imt-emabot/CFR_2027/commun/outils/ImgToGcode/image.png

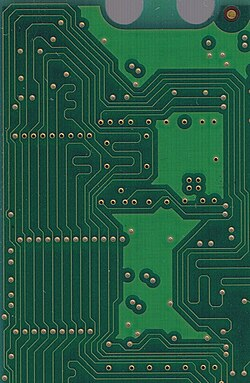
commun/outils/ImgToGcode/image.png
