imt-emabot/CFR_2027/mat/elec/README.md

# Électronique — mât

Rien de dédié pour l'instant. Le calculateur est un Raspberry Pi 5 du commerce (CDC mât,
section 7) et la batterie proposée est une batterie d'outillage électroportatif avec
convertisseur du commerce, sans PCB dédié (section 8.1). Ce dossier reçoit ce qui
deviendrait nécessaire — point d'accès dédié (section 6.2), câblage d'alimentation.
