imt-emabot/CFR_2027/pami/meca/README.md

# Mécanique — PAMI

Mécanique des sept PAMI. Contrainte de gabarit réglementaire : 150 mm au départ, 350 mm
déployés (CDC logiciel, section 14.6).
