imt-emabot/CFR_2027/robot_principal/elec/alim/README.md

# Carte alimentation

STM32. Entrée LiPo 4S. Sorties 5 V puissance, 5 V commande, 5 V Pi, 12 V puissance.
Mesure de courant et tension par INA3221 (3 canaux, 0,25 %) sur shunts de 8 mΩ 1 W.
Sorties commutées par relais G2RL-2 DPDT 8 A 12 V. DAC MCP4725 présent.

Renvois : CDC logiciel, section 1.3 (chiffrage de la résolution et de la limite de
courant réelle), section 11.2 (contraintes de coupure).
