imt-emabot/CFR_2027/robot_principal/elec/carte_bat/README.md

# Carte batterie

STM32. Carte de gestion de la batterie du robot principal, distincte de la carte
alimentation (`../alim/`) qui distribue le courant vers les sorties.
