imt-emabot/CFR_2027/robot_principal/logiciel/core/README.md

# core

Processus qui ne doit jamais tomber en match (CDC logiciel, section 4.4) : tirette,
machine à états de match, passerelle CAN, chien de garde, pilote lidar et réflexe
obstacle, IHM d'état.

Renvois : contrat de la carte moteurs (section 7), bus CAN (section 8), lidar remonté en
couche 1 (section 9.1).
