imt-emabot/CFR_2027/robot_principal/logiciel/perception/README.md

# perception

Caméra embarquée et client du mât (CDC logiciel, section 4.4). Peut redémarrer en match.

Renvois : caméra embarquée (section 9.2), dispositif de calcul et d'observation déporté
et calibration continue (section 10). Le mât n'est jamais un participant DDS : ce paquet
est la passerelle applicative qui reçoit ses messages UDP (CDC mât, section 6.4).
