imt-emabot/CFR_2027/robot_principal/logiciel/tooling/README.md

# tooling

Enregistrement, télémétrie, visualisation (CDC logiciel, section 4.4). Tué d'office au
coup de tirette en mode match officiel — F.6 interdit toute communication avec un système
extérieur à la table pendant un match (section 12).

Renvois : enregistrement, rejeu et capitalisation (section 5.7 et section 19). Le pont
vers le simulateur est un composant séparé, voir `../simulateur/`.
