imt-emabot/CFR_2027/docs/README.md

# Documentation

Documents transverses au projet.

- `cdc/` — cahiers des charges et leur outillage de traçabilité. Voir
  [`cdc/conventions-cdc.md`](cdc/conventions-cdc.md) avant toute modification.
- `robotcoup.drawio` / `robotcoup.drawio.png` — schéma du robot.
- [`procedure-preparation-3min.md`](procedure-preparation-3min.md) — procédure de
  préparation en trois minutes (fiche 17.11 du CDC logiciel).
- [`analyse-reglement-2027-beta.md`](analyse-reglement-2027-beta.md) — confrontation du
  règlement 2027 bêta aux CDC ; liste de travail avant la passe de révision.
