imt-emabot/CFR_2027/commun/README.md

# Commun

Ce qui ne relève d'aucun sous-système en particulier — robot principal, mât ou PAMI —
mais s'applique à plusieurs d'entre eux.

- [`elec/`](elec/) — normes électriques internes à l'équipe.
- [`outils/`](outils/) — utilitaires de fabrication.
