imt-emabot/CFR_2027/mat/README.md

# Mât — dispositif de calcul et d'observation déporté

Tout ce qui constitue le mât : électronique, mécanique, logiciel.

- [`elec/`](elec/) — électronique du mât.
- [`meca/`](meca/) — structure mécanique du mât.
- [`logiciel/`](logiciel/) — logiciel du calculateur embarqué.

L'architecture, les choix actés et leurs motifs vivent dans `docs/cdc/cdc-mat-v0_3.md` ;
ces dossiers n'en sont que la structure de code (règle 5 de `docs/cdc/conventions-cdc.md`).
