imt-emabot/CFR_2027/pami/elec/README.md

# Électronique — PAMI

Électronique embarquée des sept PAMI : microcontrôleur Wi-Fi, démarreur physique propre
à chaque PAMI, sélecteur de couleur d'équipe et sélecteur de numéro — les trois servent au
niveau de repli 3, quand le PAMI n'a jamais été connecté au serveur (CDC logiciel, section
14.3).
