imt-emabot/CFR_2027/commun/elec/README.md

# Électronique — commun

- `norme_intern_elec.xlsx` — normes électriques internes à l'équipe, applicables à toutes
  les cartes, quel que soit le sous-système.
