imt-emabot/CFR_2027/commun/outils/README.md

# Outils — commun

Scripts et utilitaires de fabrication, indépendants de tout sous-système.

- `ImgToGcode/` — conversion d'une image en G-code (détection de contours OpenCV) pour
  découpe/gravure.
