imt-emabot/CFR_2027/mat/meca/README.md

# Mécanique — mât

Structure du mât, deux options maintenues en parallèle à ce stade (CDC mât, section 8.3).
Ventilateur actif obligatoire pour le calculateur en boîtier fermé (section 7).
