imt-emabot/CFR_2027/robot_principal/meca/README.md

# Mécanique — robot principal

Pièces et sous-ensembles mécaniques du robot principal (conceptions Fusion 360).

- `support ventilo.f3d` — support de refroidissement de l'électronique embarquée.
