imt-emabot/CFR_2027/robot_principal/logiciel/nav/README.md

# nav

Nav2, costmaps, planificateur global (CDC logiciel, section 4.4). Peut redémarrer en
match, `RestartSec` croissant.

Renvois : navigation et articulation avec la carte moteurs par flux de waypoints
remplaçable (sections 4.2 et 5), dimensionnement de l'évitement (section 5.4).
