imt-emabot/CFR_2027/robot_principal/logiciel/strategy/README.md

# strategy

Moteur de stratégie (CDC logiciel, section 4.4). Peut redémarrer en match ; le robot
bascule sur une séquence forcée pendant son absence.

Renvois : stratégie et machine à états de match (section 11), fenêtre PAMI et niveaux de
repli à sélectionner (section 14.6), format du fichier de description des actions
(section 17.6, à figer).
