imt-emabot/CFR_2027/docs/cdc/matrice-tracabilite.md

# Matrice de traçabilité

*Généré par `verif_cdc.py --matrice`. Ne pas modifier à la main.*

## LOG — Logiciel embarqué du robot principal

| Exigence | Origine | Vérif. | Essais | Liens sortants | Liens entrants |
|---|---|---|---|---|---|
| LOG-EXD-01 | B2 | E | — | — | — |
| LOG-EXD-02 | B4 | I | — | — | — |
| LOG-EXD-03 | B6 | I | — | — | — |
| LOG-EXD-04 | B2 | I | — | — | — |
| LOG-EXD-05 | B1, B6 | I | — | — | — |
| LOG-EXE-01 | — | E | V6 | — | MAT-MXE-01, MAT-MXF-11 |
| LOG-EXE-02 | — | I | — | — | — |
| LOG-EXE-03 | — | E | — | — | — |
| LOG-EXE-04 | — | I | — | — | — |
| LOG-EXE-05 | — | EI | — | — | — |
| LOG-EXE-06 | — | E | V4 | — | — |
| LOG-EXE-07 | — | I | — | — | — |
| LOG-EXF-01 | B3 | E | — | — | — |
| LOG-EXF-02 | B3 | E | — | — | — |
| LOG-EXF-03 | B3 | E | — | — | — |
| LOG-EXF-04 | B3 | E | — | — | — |
| LOG-EXF-05 | B3 | E | — | — | — |
| LOG-EXF-06 | B1 | I | — | — | — |
| LOG-EXF-07 | B2, B5 | E | — | — | — |
| LOG-EXF-08 | B3 | E | — | — | MAT-MXF-03 |
| LOG-EXF-09 | B2 | E | V2 | — | MAT-MXS-03 |
| LOG-EXF-10 | B3 | E | — | — | — |
| LOG-EXF-11 | B3 | AE | V13 | — | MAT-MXF-04, MAT-MXF-05, MAT-MXP-06 |
| LOG-EXF-12 | B3, B4 | E | V8 | — | — |
| LOG-EXF-13 | B4 | I | — | — | — |
| LOG-EXJ-01 | — | E | V9 | — | — |
| LOG-EXJ-02 | — | E | V9 | — | — |
| LOG-EXJ-03 | — | E | V9 | — | — |
| LOG-EXJ-04 | — | AE | V9 | — | MAT-MXF-12, MAT-MXP-03 |
| LOG-EXJ-05 | — | I | V9 | — | — |
| LOG-EXJ-06 | — | I | V9 | — | — |
| LOG-EXJ-07 | — | AE | V9 | — | — |
| LOG-EXJ-08 | — | E | V9 | — | — |
| LOG-EXJ-09 | — | E | V9 | — | — |
| LOG-EXJ-10 | — | I | V9 | — | — |
| LOG-EXJ-11 | — | E | V9 | — | — |
| LOG-EXJ-12 | — | E | V10 | — | — |
| LOG-EXJ-13 | — | EI | V10 | — | — |
| LOG-EXJ-14 | — | E | V10 | — | — |
| LOG-EXJ-15 | — | I | V10 | — | — |
| LOG-EXP-01 | — | AE | V8 | — | — |
| LOG-EXP-02 | — | E | — | — | — |
| LOG-EXP-03 | — | AE | V8 | — | — |
| LOG-EXP-04 | — | A | — | — | — |
| LOG-EXP-05 | — | E | — | — | — |
| LOG-EXP-07 | — | E | V11 | — | — |
| LOG-EXR-01 | H.3, H.4 | EH | V5 | — | — |
| LOG-EXR-02 | H.4 | E | V5 | — | — |
| LOG-EXR-03 | H.4, I.3.b | EH | V1 | — | — |
| LOG-EXR-04 | H.4 | I | — | — | — |
| LOG-EXR-05 | H.1, H.4 | E | V6 | — | — |
| LOG-EXR-06 | H.4 | E | V6 | — | — |
| LOG-EXR-07 | H.4 | AE | — | — | — |
| LOG-EXR-08 | F.6 | I | — | — | MAT-MXR-06 |
| LOG-EXR-09 | I.3.b | H | V7 | — | — |
| LOG-EXR-10 | F.3 | EI | V7 | — | — |
| LOG-EXR-11 | F.6 | I | — | — | MAT-MXR-08 |
| LOG-EXR-12 | F.6 | I | — | — | — |
| LOG-EXS-01 | P6 | E | V4 | — | — |
| LOG-EXS-02 | P3 | E | V1 | — | — |
| LOG-EXS-03 | P3 | E | V2 | — | MAT-MXS-02 |
| LOG-EXS-04 | P4 | E | V5 | — | — |
| LOG-EXS-05 | P3, P4 | E | V1 | — | — |
| LOG-EXS-06 | P4 | E | V11 | — | — |
| LOG-EXS-07 | P4 | EI | V12 | — | MAT-MXS-05 |
| LOG-EXS-08 | P4 | I | V12 | — | — |
| LOG-EXS-09 | B2 | E | V3 | — | — |
| LOG-EXS-10 | B2 | E | V3 | — | — |
| LOG-EXS-11 | B4 | E | V12 | — | — |
| LOG-EXS-12 | P2 | AE | V13 | — | MAT-MXP-01, MAT-MXS-04 |

## MAT — Dispositif de calcul et d'observation déporté

| Exigence | Origine | Vérif. | Essais | Liens sortants | Liens entrants |
|---|---|---|---|---|---|
| MAT-MXD-01 | Q1, B6 | I | — | — | — |
| MAT-MXD-02 | Q1 | E | M3 | — | — |
| MAT-MXD-03 | B6 | I | — | — | — |
| MAT-MXD-04 | B6 | I | — | — | — |
| MAT-MXE-01 | — | E | M1 | LOG-EXE-01 | — |
| MAT-MXE-02 | — | E | M1 | — | — |
| MAT-MXE-03 | — | I | — | — | — |
| MAT-MXE-04 | — | I | — | — | — |
| MAT-MXE-05 | — | I | — | — | — |
| MAT-MXE-06 | — | E | M8 | — | — |
| MAT-MXF-01 | B1 | E | — | — | — |
| MAT-MXF-02 | B2 | E | — | — | — |
| MAT-MXF-03 | B2 | E | — | LOG-EXF-08 | — |
| MAT-MXF-04 | B3 | E | — | LOG-EXF-11 | — |
| MAT-MXF-05 | B3 | EI | M6b | LOG-EXF-11 | — |
| MAT-MXF-06 | B3 | E | M8 | — | — |
| MAT-MXF-07 | B5 | E | — | — | — |
| MAT-MXF-08 | B3 | AE | — | — | — |
| MAT-MXF-09 | B4 | E | M3 | — | — |
| MAT-MXF-10 | B2 | I | — | — | — |
| MAT-MXF-11 | B5 | I | M8 | LOG-EXE-01 | — |
| MAT-MXF-12 | B3 | AE | M6b | LOG-EXJ-04 | — |
| MAT-MXP-01 | — | AE | M6 | LOG-EXS-12 | — |
| MAT-MXP-02 | — | AE | M6 | — | — |
| MAT-MXP-03 | — | AE | M6 | LOG-EXJ-04 | — |
| MAT-MXP-04 | — | AE | M5 | — | — |
| MAT-MXP-05 | — | E | M4 | — | — |
| MAT-MXP-06 | — | AE | M6b | LOG-EXF-11 | — |
| MAT-MXR-01 | G.4 | HI | M9 | — | — |
| MAT-MXR-02 | G.4 | HI | M9 | — | — |
| MAT-MXR-03 | G.4 | HI | M9 | — | — |
| MAT-MXR-04 | G.4 | HI | M1 | — | — |
| MAT-MXR-05 | F.4.c | I | M10 | — | — |
| MAT-MXR-06 | F.6 | I | M10 | LOG-EXR-08 | — |
| MAT-MXR-07 | F.4.b | HI | M10 | — | — |
| MAT-MXR-08 | F.6 | HI | M10 | LOG-EXR-11 | — |
| MAT-MXS-01 | Q1 | E | M3 | — | — |
| MAT-MXS-02 | Q2 | E | M2 | LOG-EXS-03 | — |
| MAT-MXS-03 | Q2 | E | M2 | LOG-EXF-09 | — |
| MAT-MXS-04 | Q3 | AE | — | LOG-EXS-12 | — |
| MAT-MXS-05 | Q3 | I | — | LOG-EXS-07 | — |
| MAT-MXS-06 | Q3 | E | M4 | — | — |
| MAT-MXS-07 | Q3 | E | M5 | — | — |
| MAT-MXS-08 | B6 | AE | M7 | — | — |
