imt-emabot/CFR_2027/archive/README.md

# Archive

Fichiers conservés sans usage actif (tests, brouillons obsolètes). Rien ici n'est
nécessaire au bon fonctionnement du projet.

- `ceci est un test pour le chat.txt` — fichier de test vide, sans contenu.
