imt-emabot/CFR_2027/docs/Maverick-Gearbox-Information.webp

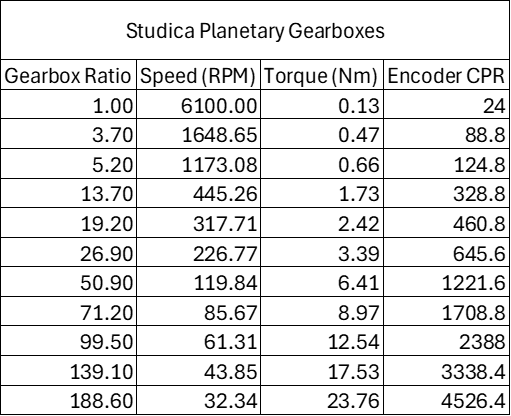
docs/Maverick-Gearbox-Information.webp
