imt-emabot/CFR_2027/docs/robotcoup.drawio.png

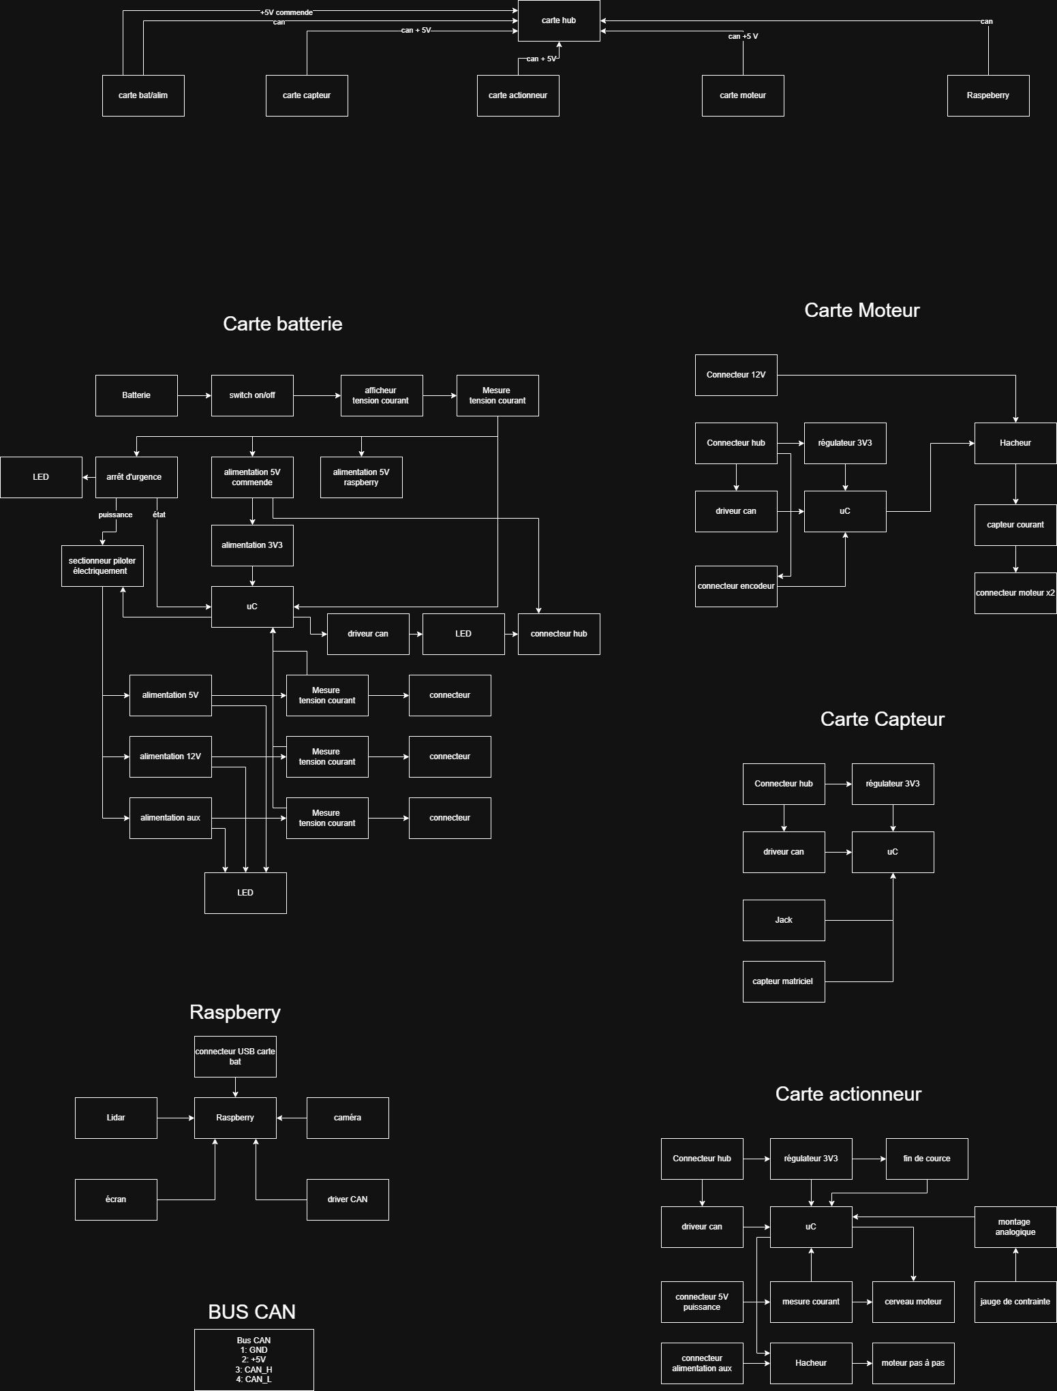
docs/robotcoup.drawio.png
