imt-emabot/CFR_2027/(list of files, cad)

Other CAD files:
robot_principal/elec/alim/Alim.f3d
robot_principal/elec/carte_bat/carte_bat_cdf27.f3z
robot_principal/meca/support ventilo.f3d
