imt-emabot/CFR_2027/(commit log)

2026-07-04 add draw io
    draw io de roboto principale
2026-07-20 3D à imprimer pour le local
    [Alim.f3d, support ventilo.f3d]
2026-07-27 ImgToGcode
    Pour la lithographie ou gravure laser ou éventuellement l'impression 3D
2026-08-09 add carte bat
    [carte_bat_cdf27.f3z]
2026-08-12 finish préliminaire carte bat
    [carte_bat_cdf27.f3z]
2026-09-08 Réorganise le dépôt par sous-système (robot principal, mât, PAMI, commun)
    Regroupe le CDC logiciel, la traçabilité et l'outillage IA (AGENTS.md,
    skill Claude Code) à leurs emplacements conventionnels, et déplace le
    code et le matériel existants sous robot_principal/, mat/, pami/ et
    commun/, chacun divisé en elec/meca/logiciel. Aucun fichier supprimé,
    uniquement déplacé ; les nouveaux dossiers vides (mat/elec, pami/*)
    sont préparés avec un README renvoyant au CDC correspondant.
    [Alim.f3d, carte_bat_cdf27.f3z, norme_intern_elec.xlsx, support ventilo.f3d]
2026-09-08 Procédure de préparation, garde-fous de couleur et vue d'ensemble des connexions
    Rédige la procédure de préparation en trois minutes (fiche 17.11), tranche
    le lieu de saisie de la couleur d'équipe et de la hauteur de marqueur
    (question 14 de LOG 16.4 / point 6 de MAT 13) avec un garde-fou à trois
    niveaux : robot autorité par défaut, sélecteur de secours sur la page du
    mât pour la couleur seule, sélecteurs physiques sur chaque PAMI en dernier
    recours. Impose qu'une couleur non confirmée bloque le démarrage de
    `vision`, plutôt que de risquer une pose fausse mais plausible.
    Ajoute une vue d'ensemble des connexions et de leurs replis dans les deux
    CDC (LOG 13.4, MAT 9.3), qui ind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
2026-09-19 Add software heritage report for 2026 robotics competition
    This commit introduces a comprehensive report detailing the software heritage from the 2026 robotics competition. The document includes an analysis of the existing codebase, comparisons between the ROS and non-ROS branches, and an inventory of reusable components. It also outlines the current state of compliance with software requirements and identifies areas for improvement and necessary rewrites for the upcoming 2027 competition.
2026-09-23 Ajoute la structure de base pour les packages ROS 2 : core, nav, perception, strategy et tooling, avec les fichiers README, CMakeLists et package.xml correspondants. Supprime les anciens fichiers REA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
2026-09-23 Ajout de l'ihm 2026 en tant qu'héritage pour la porter dans la nouvelle architecture
2026-09-23 Mise à jour du cahier des charges pour l'IHM : clarification des décisions d'architecture, séparation des processus et sécurité du serveur. Reprise de la base visuelle et refonte du comportement.
2026-09-23 Ajoute le message `SEQ_RESET` pour réinitialiser le contexte de séquence et clarifie la passerelle bidirectionnelle entre CAN et ROS.
2026-09-23 Ajout d'une étude détaillée sur le moteur de locomotion Maverick Hex Planetary Gearbox Motor, incluant des données techniques, des hypothèses de simulation, des calculs électromécaniques, et des reco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
2026-09-23 Mise à jour du fichier .gitignore pour inclure des secrets et fichiers de configuration locaux, ainsi que des artefacts de construction. Ajout d'une section sur l'état du projet dans le README.md pou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
